dig-flowspace/EnderCNCs/docs/models/mgn/BOM.md

---
title: Bill of Materials - MGN build
doc-type: bom
authored-by: Dan (dig-flowspace)
compiler: digvoice
llm-assisted: false
source: E3CNC / EnderCNCs MGN build documentation
scope: Belted MGN build, whole machine
git-first-commit: ccf44c8 "Add Bill of Materials and README for MGN build guide"
date-created: 2026-08-24
date-modified: 2026-09-07
---

# Bill of Materials

This chapter covers the BOM for the **MGN** build of Ender3CNC.

### Must buy for any Ender 3 used: 
| Qty | Part Description | Specifications | Notes |
|-----|---|---|---|
| **Motion Components** |
| 3x  | GT2 belts | 350mm length, 6mm width  | Buy 3-5 meter roll |
| 3x  | GT2 pulleys | 20T, 6mm width, 5mm bore | |
| 2x  | MGN12H linear rails | 150mm length | 1 carriage per rail |
| 2x  | 608ZZ bearings | 8x22x7mm | Or use 688 from Ender 3 |
| **Electronics** |
| 4x  | D2F-L Microswitch | Limit switch | Get 10 pack / use original |
| **Fasteners** |
| 20x | M3 T-nuts | For 2020 extrusion | Sliding or standard t-nuts |
| 40x | M5 T-nuts | For 2020 extrusion | Sliding or standard t-nuts |
| 10x | M5 locknuts | Hex nuts | |
| 70x | M5x16 button head | | |
| 22x | M3x10 screws | Not countersunk | |
| 12x | M3x8 SHCS | Socket head cap screws | |
| 1x | M5x65 | Socket/button head SC | Need 1 for the middle wheel|
| **Hardware** |
| 30x | Heat set inserts | M3x4x5mm | Voron spec |
| 4x  | M5 shims | OD 10mm, ID 5mm, 1mm | Washers |

## Optional Upgrades

| Qty | Part Description | Specifications | Purpose |
|-----|---|---|---|
| 8x  | Aluminum spacers | 5mm ID x 8mm OD x 8mm length | Replaces printed Y axis wheel spacers |

### Extrusions are only needed if you have the original Ender 3[not PRO] with a 2040 under the bed. 
### If you have the Ender 3 PRO with 4040 under the bed you may need to cut it. 

| Qty | Part Description | Specifications | Notes |
|-----|---|---|---|
| **Extrusion** |
| 2x  | 2040 v-slot | 300mm | Only for Original Ender |
**OR**
| 1x  | 4040 v-slot         | 300mm                    | Only for Original Ender    |
-------------------------------------------------------------------------------------

---

## Ready to Proceed?

You are now ready to move on to **Preparing the tool Carriage**.

<p align="center">
  <a href="/EnderCNCs/models/vwheel/carriage_prep" class="md-button md-button--primary">
    Continue to Carriage Preparation →
  </a>
</p>

Ender 3 Parts Breakdown
## Parts Reused from Ender 3 

| Qty | Part Description | Notes |
|-----|---|---|
| **Extrusions** |
| 1x  | 2020 v-slot Profile | To be cut in half |
| 2x  | 4040 v-slot Profile | |
| 2x  | 2040 v-slot Profile | |
| 1x  | 4040 v-slot Profile | Ender 3 Pro Only |
| **M5 Screws** |
| 10x | M5x30 button head | |
| 16x | M5x45 bolts | From the frame (remove shims) |
| 4x  | M5x8 | |
| 1x  | M5x65 | Middle lower X axis wheel |
| All | M5 nuts | |
| **M4 Screws** |
| 2x  | M4x20 | |
| 2x  | M4x16 | |
| 2x  | M4x10 | Includes 2x M4 t-nuts |
| **M3 Screws** |
| 6x  | M3x10 | |
| 11x | M3x10 | Additional needed |
| 4x  | M3x40 | |
| 12x | M3x6 | |
| **Bearings** |
| 2x  | 688 bearings | If available |

!!! Note
    You can re-use 2 belt lengths from the Ender 3, but you still need one more ~350mm length. 

!!! Tip
    You can re-use 3 limit switches from the Ender 3, if you want to cut them off the PCB's but you'll still be missing 1, so you need to order AT LEAST 1 more, it is probably easier just to buy a new set if you go with this option. The recommendation is to go with the endstop mod.

 Adapted for 350MM MGN Rails
- Adjusted Rail Positioning
- Shuffled End-stops location to reflect changes made to carriages.
- Added Addition End-Stop locations for boards that support it.
- Two threaded nuts per Axis with both 3mm and threaded inset options on all axis.
- Moved X Axis cable chain to allow for a mounting position on the Y gantry.
- Measurements were confirmed with data/spec sheets and referenced the original E3CNC CAD for tolerances.
- Moved Z Axis forward 2mm (to compensate for Z Axis threaded rod connection change, needed extending backwards by 2mm).
- Updated 52mm and 65mm 3D printed Spindle mounts to match New Z Axis Position.
- Updated 52MM Spindle clamp mount (for the metal clamp that comes with many 52mm Spindles and spindle kits).
- Added Subframe support and work holding options (will require extra extrusion. 1x 400mm 4020 cut to length (~360mm) and 2x 300mm 4020 can be left at 300mm).
- Includes some test 3D prints for spacing and sizing of MGN12 carriages, vertical and horizontal holes, threaded rod connections, and Z carriage rail spacing for the main X extrusion.
- Added alternative Y/Y1 Gantry pieces that lower the print time by a smidgen.
- Added alternative front corner blocks for 360MM rails.
