dig-flowspace/EnderCNCs/docs/models/mgn/references/discord-notes.md

---
title: Yet Another MGN12 Mod - build log notes
doc-type: reference-note
authored-by: Dan (dig-flowspace)
compiler: digvoice
llm-assisted: false
source: EnderCNCs Discord, user-builds channel
note: Builder's own handle appears in the body; quoted with attribution.
date-compiled: 2026-08-24
date-modified: 2026-08-24
---

---
## Yet Another MGN12 Mod - Build Log (@daniel_stoelzner)

| Links and Sources | |
| --- | --- |
| **Discord Link**  | [user-builds &gt; Yet Another MGN12 Mod - Build Log](https://discord.com/channels/1398053352960561302/1534193914590789746) |
| **Builder** | @daniel_stoelzner |
| **Source Files**  | [www.printables.com/model/1689612-e3cnc-mgn-mod-alt-threaded-rod-version-2](https://www.printables.com/model/1689612-e3cnc-mgn-mod-alt-threaded-rod-version-2) |
### Notes
- **Filament(s)**
	- Favored Tinmorry PETG-CF
		- "This PETG-GF is my new favorite filament. It's plenty strong and prints just as easily as PLA. ""
	- Everything is ordered from Taobao
- **Changes from Base**
	- Right now the build plate consists of 2 15120 profiles but I can't mount them as rigidly as I would like
		- Instead he used a 20240
			- "Should be better than trying to attach a 15mm profile to 2040/4040 beams"
			- ![[Pasted image 20260824205408.png]]
	- In order to have enough clearance underneath, I'm **changing the bottom cross beam to a 1040 profile with an additional angle bracket connected to the Y gantry**. Right now I'm printing the spindle mounting plate which will use **chunkier 12x12x5 metal plates** instead of nuts for the spindle mounting screws.
