dig-flowspace/EnderCNCs/docs/models/mgn/images/Pasted image 20260824205408.png

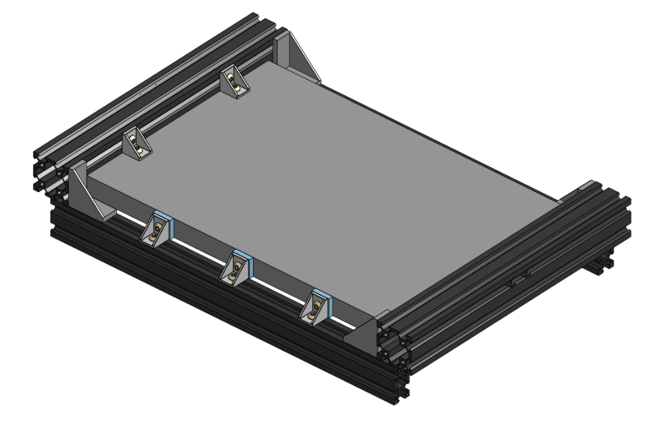
docs/models/mgn/images/Pasted image 20260824205408.png
