dig-flowspace/EnderCNCs/docs/models/mgn/references/images/Pasted image 20260907084838.png

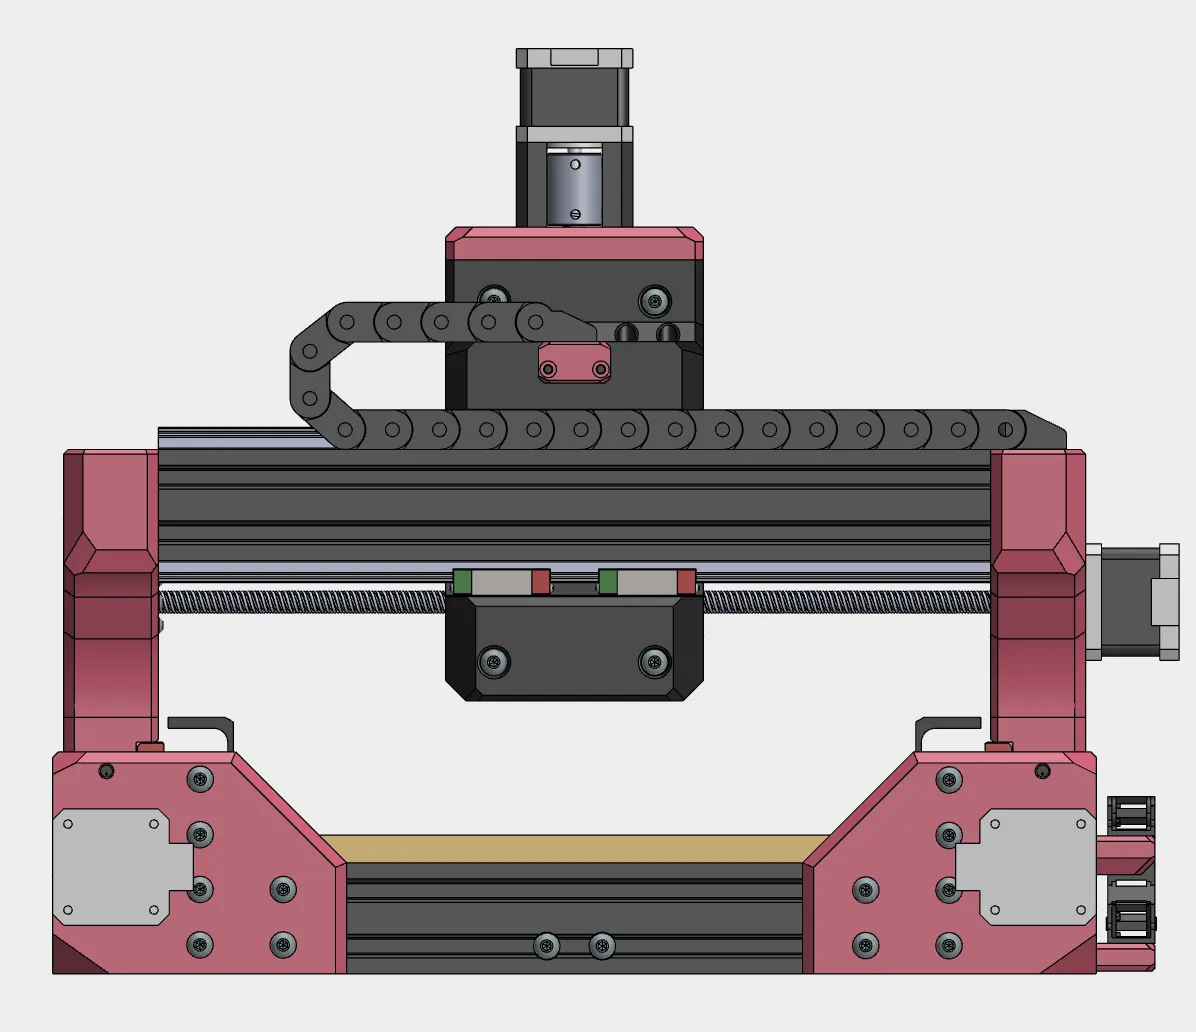
docs/models/mgn/references/images/Pasted image 20260907084838.png
