dig-flowspace/EnderCNCs/docs/models/mgn/images/Screenshot_2026-08-08_at_16-09-59_cnc3_mgn_mod_version-3_parts.png

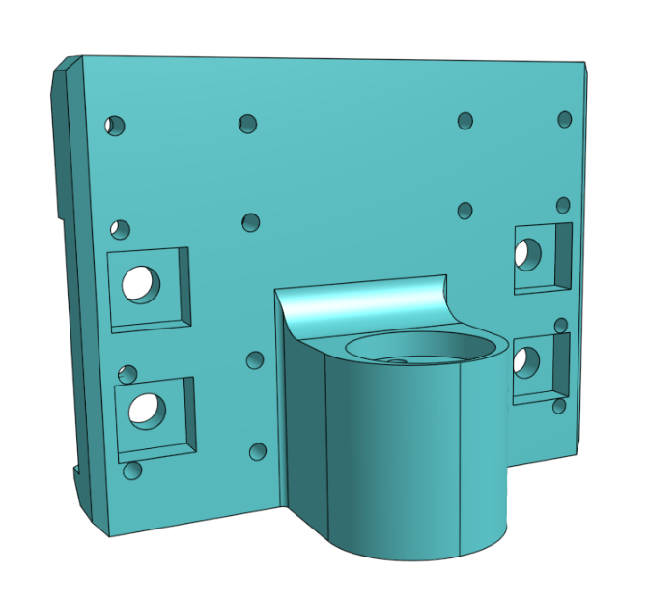
docs/models/mgn/images/Screenshot_2026-08-08_at_16-09-59_cnc3_mgn_mod_version-3_parts.png
