dig-flowspace/EnderCNCs/docs/models/mgn/references/e3cnc-mgn-mod-alt-threaded-rod-version-2-model_files/MGN MOD ALT (VERSION 1)/e3cnc_mgn_mod_alt_52mm_mount_full.step

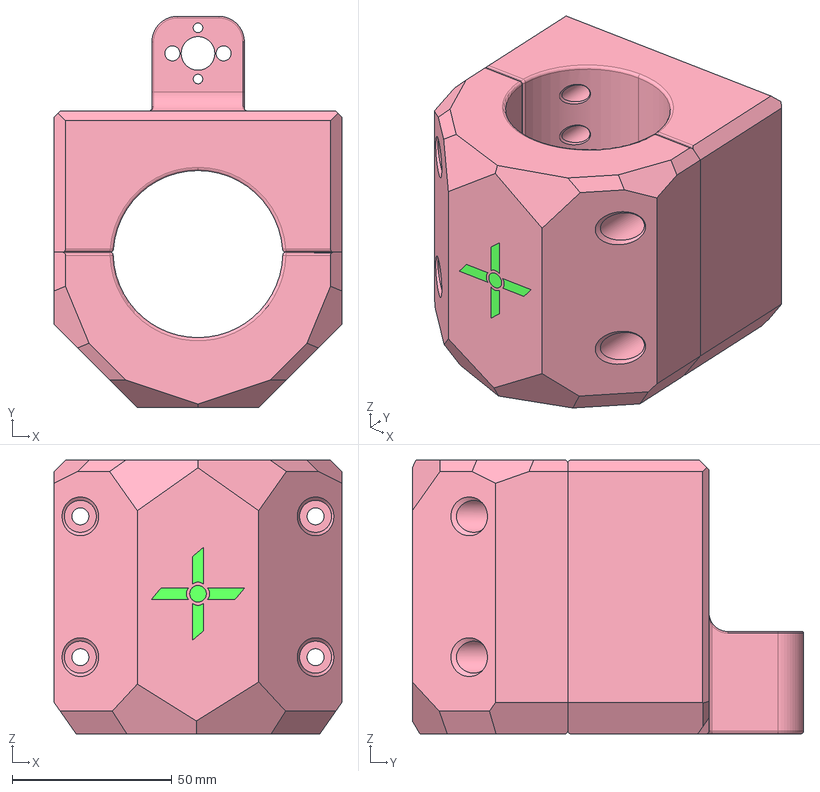
[picture p18: CAD file, 2026-09-12]
docs/models/mgn/references/e3cnc-mgn-mod-alt-threaded-rod-version-2-model_files/MGN MOD ALT (VERSION 1)/e3cnc_mgn_mod_alt_52mm_mount_full.step
90.0 x 122.3 x 85.6 mm
52MM SPINDLE MOUNT PRINTS
LOGO
