dig-flowspace/EnderCNCs/docs/models/mgn/references/e3cnc-mgn-mod-alt-threaded-rod-version-2-model_files/ALTERNATE PARTS (UNIVERSAL)/e3cnc_mgn_mod_alt_y_gantry.step

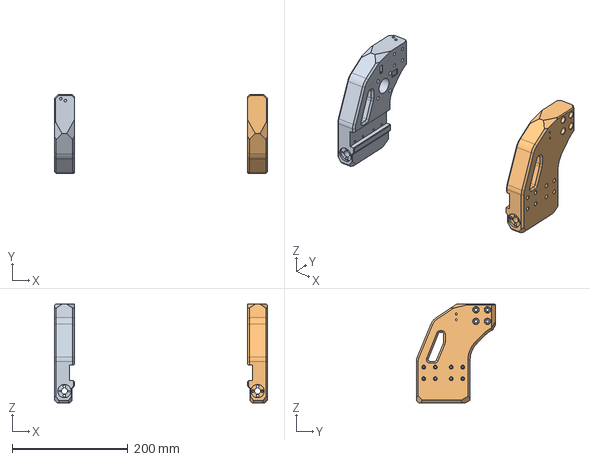
[picture p19: CAD file, 2026-09-12]
docs/models/mgn/references/e3cnc-mgn-mod-alt-threaded-rod-version-2-model_files/ALTERNATE PARTS (UNIVERSAL)/e3cnc_mgn_mod_alt_y_gantry.step
368.4 x 137.0 x 171.0 mm
