dig-flowspace/EnderCNCs/docs/models/mgn/references/e3cnc-mgn-mod-alt-threaded-rod-version-2-model_files/MGN MOD ALT (VERSION 1)/e3cnc_mgn_mod_alt_52mm_mount_clamp.step

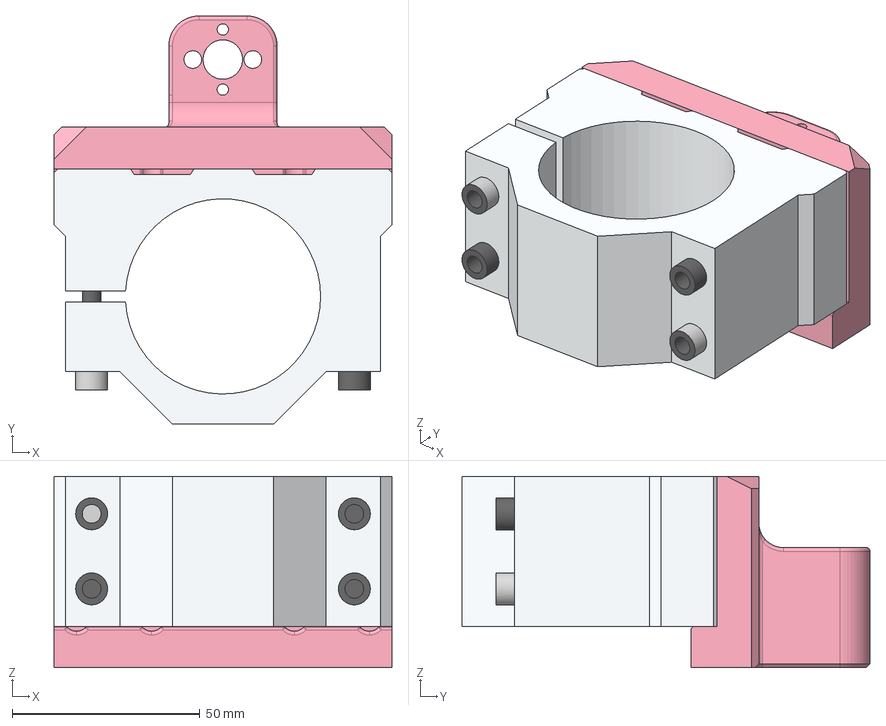
[picture p20: CAD file, 2026-09-12]
docs/models/mgn/references/e3cnc-mgn-mod-alt-threaded-rod-version-2-model_files/MGN MOD ALT (VERSION 1)/e3cnc_mgn_mod_alt_52mm_mount_clamp.step
90.0 x 108.7 x 51.0 mm
