dig-flowspace/EnderCNCs/docs/models/mgn/references/e3cnc-mgn-mod-alt-threaded-rod-version-2-model_files/PRINT TESTING/e3cnc_mgn_mod_alt_x_gantry_print_test.step

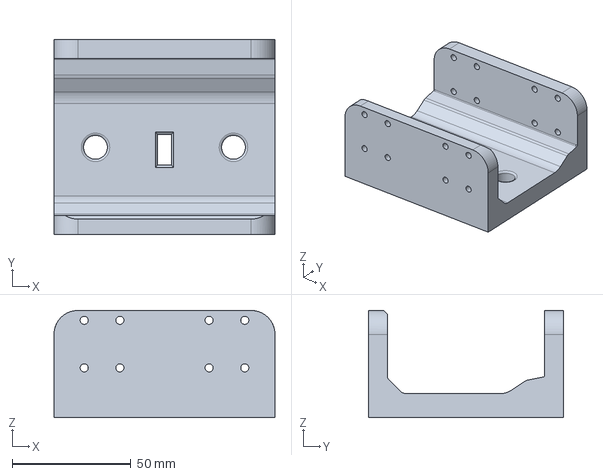
[picture p21: CAD file, 2026-09-12]
docs/models/mgn/references/e3cnc-mgn-mod-alt-threaded-rod-version-2-model_files/PRINT TESTING/e3cnc_mgn_mod_alt_x_gantry_print_test.step
92.9 x 82.0 x 45.0 mm
