dig-flowspace/EnderCNCs/docs/models/mgn/references/e3cnc-mgn-mod-alt-threaded-rod-version-2-model_files/ALTERNATE PARTS (UNIVERSAL)/e3cnc_mgn_mod_alt_front_corner_360mm.step

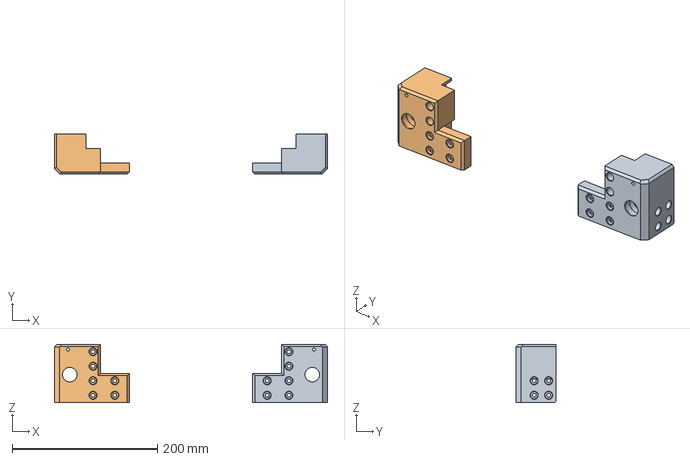
[picture p22: CAD file, 2026-09-12]
docs/models/mgn/references/e3cnc-mgn-mod-alt-threaded-rod-version-2-model_files/ALTERNATE PARTS (UNIVERSAL)/e3cnc_mgn_mod_alt_front_corner_360mm.step
376.2 x 55.0 x 80.0 mm
