dig-flowspace/EnderCNCs/docs/models/mgn/references/e3cnc-mgn-mod-alt-threaded-rod-version-2-model_files/PRINT TESTING/e3cnc_mgn_mod_alt_carriage_print_test.step

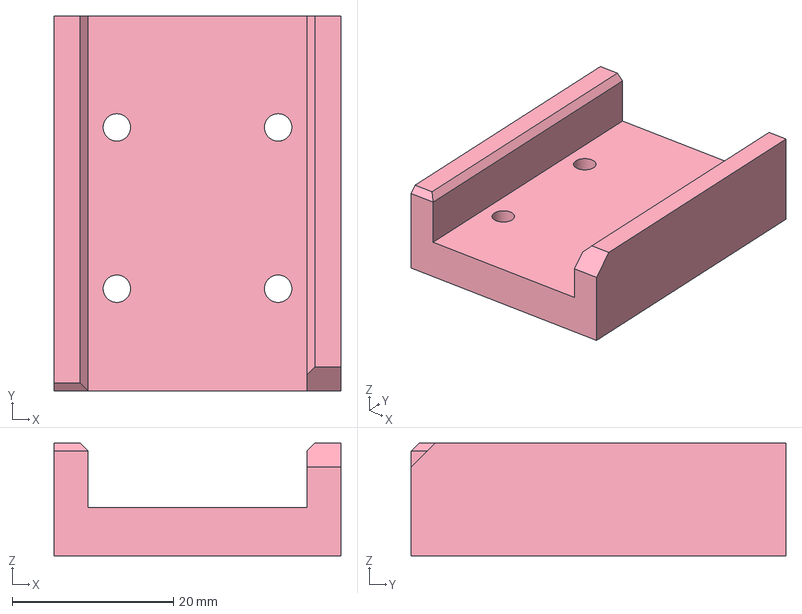
[picture p23: CAD file, 2026-09-12]
docs/models/mgn/references/e3cnc-mgn-mod-alt-threaded-rod-version-2-model_files/PRINT TESTING/e3cnc_mgn_mod_alt_carriage_print_test.step
35.6 x 46.5 x 14.0 mm
