dig-flowspace/EnderCNCs/docs/models/mgn/references/e3cnc-mgn-mod-alt-threaded-rod-version-2-model_files/PRINT TESTING/e3cnc_mgn_mod_alt_hole_print_test.step

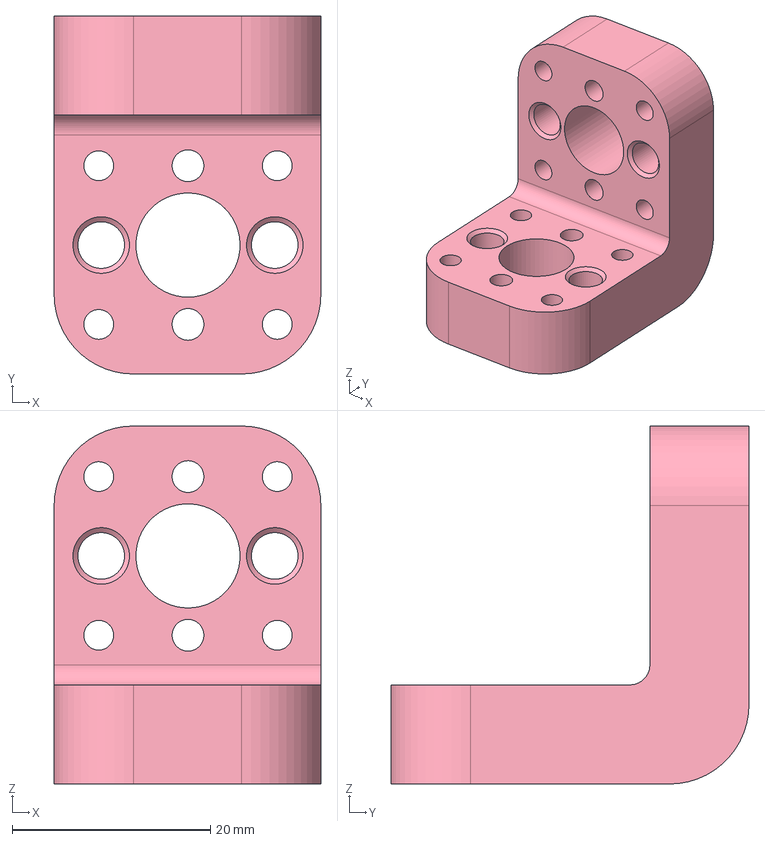
[picture p24: CAD file, 2026-09-12]
docs/models/mgn/references/e3cnc-mgn-mod-alt-threaded-rod-version-2-model_files/PRINT TESTING/e3cnc_mgn_mod_alt_hole_print_test.step
26.9 x 36.1 x 36.1 mm
