dig-flowspace/EnderCNCs/docs/models/mgn/references/printables-chauk-e3cnc-mgn-mod.md

---
source-url: https://www.printables.com/model/1689612-e3cnc-mgn-mod-alt-threaded-rod-version-2
op-author: Chauk
compiler: digvoice
date-compiled: 2026-09-07
title: E3CNC MGN Mod Alt (threaded rod) v2 - reference note
doc-type: reference-note
authored-by: Dan (dig-flowspace)
llm-assisted: false
lineage: Downstream remix of the E3CNC MGN mod; names shared with the BETA CAD
  are inherited from it, not independently derived.
date-modified: 2026-09-07
---
# E3CNC MGN MOD ALT (THREADED ROD) (VERSION 2)

## Short Description
Remixed E3CNC MGN Mod with Threaded rods by Ravenkeeper. Original Creator: https://www.printables.com/@Tony_409529
## Description
**UPDATES VERSION 2 (Tested)**
- Returns to standard tool mounting to maintain compatibility of the original designs tool heads and bearing plates.  
- Added a hole for allowing the X Axis rod extend past the Gantry.  
- QOL improvements.  
- Bottom side gantry support mounting added.  
  
**UPDATES: 5/26/26 (Tested)**  
- Add more alternate options.   
- X Axis rod opening  
  
**UPDATES: 4/21/26**  
- Fix Widened D2F-L by 0.3mm. Issue exists on the corner blocks only. All other parts were unaffected. Both 350mm and 360mm corner blocks were addressed. A couple passes of the DF2-L on a flat piece of sand paper will be all it needs if you printed prior to 4/21/26.  
  
**This mod is a remix of the original MGN MOD with a few changes.**
- Adapted for 350MM MGN Rails
- Adjusted Rail Positioning
- Shuffled End-stops location to reflect changes made to carriages.
- Added Addition End-Stop locations for boards that support it.
- Two threaded nuts per Axis with both 3mm and threaded inset options on all axis.
- Moved X Axis cable chain to allow for a mounting position on the Y gantry.
- Measurements were confirmed with data/spec sheets and referenced the original E3CNC CAD for tolerances.
- Moved Z Axis forward 2mm (to compensate for Z Axis threaded rod connection change, needed extending backwards by 2mm).
- Updated 52mm and 65mm 3D printed Spindle mounts to match New Z Axis Position.
- Updated 52MM Spindle clamp mount (for the metal clamp that comes with many 52mm Spindles and spindle kits).
- Added Subframe support and work holding options (will require extra extrusion. 1x 400mm 4020 cut to length (~360mm) and 2x 300mm 4020 can be left at 300mm).
- Includes some test 3D prints for spacing and sizing of MGN12 carriages, vertical and horizontal holes, threaded rod connections, and Z carriage rail spacing for the main X extrusion.
- Added alternative Y/Y1 Gantry pieces that lower the print time by a smidgen.
- Added alternative front corner blocks for 360MM rails.
- I made it pink.

Notes:
- Due to the 2mm offset change on the threaded rod this is not compatible with the original tool mounts.
- Don't forget to check tolerances with the test prints!  
- There is no official BOM for this build.   
  
For rails and rods not included:  
2x 450mm TR8x8 Threaded Rod for Y and Y1 ~444mm  
1x 350mm TR8x8 Threaded Rod for X ~320mm  
2x 350mm MGN12H Linear Rails (or 360mm rails if you can find them)  
1x 300mm MGN12H Linear Rails  
All together you will need:  
6x MGN12C Carriages   
6x MGN12H Carriages  
Along with required hardware in the original build BOM.  
Plus you will need extra M3x8 and M3x10 to attach the linear rails to the extrusion and nuts for the threaded rods as well as attaching the carriages to their gantry.   

Check out the discord link in the original build description!
## Image Gallery
![[Pasted image 20260907084727.png|361]]![[Pasted image 20260907084746.png|361]]![[Pasted image 20260907084753.png|365]]![[Pasted image 20260907084805.png|360]]![[Pasted image 20260907084815.png|356]]![[Pasted image 20260907084822.png|358]]![[Pasted image 20260907084827.png|358]]![[Pasted image 20260907084832.png|356]]![[Pasted image 20260907084838.png|359]]![[Pasted image 20260907084843.png|357]]
