dig-flowspace/EnderCNCs/(commit log)

2026-08-25 Add Bill of Materials and README for MGN build guide
2026-09-12 Add MGN12 linear rails documentation and Chauk's remix reference
    - Introduced new images for MGN12 linear rails and profile rail guides.
    - Added comprehensive overview document for MGN12 linear rails, detailing specifications, definitions, and installation guidelines.
    - Created a reference note for Chauk's E3CNC MGN Mod Alt (threaded rod) v2, including updates and required components.
    [e3cnc_mgn_mod_alt_52mm_mount_clamp.step, e3cnc_mgn_mod_alt_52mm_mount_full.step, e3cnc_mgn_mod_alt_carriage_print_test.step, e3cnc_mgn_mod_alt_front_corner_360mm.step, e3cnc_mgn_mod_alt_hole_print_test.step, e3cnc_mgn_mod_alt_x_gantry_print_test.step, e3cnc_mgn_mod_alt_y_gantry.step]
